Projeto-Jupiter/PyInstrumentation2/codes/pc/hybrid_feeding_gui/trash/WhatsApp_Video_2022-12-29_at_21_48_26_AdobeExpress (1).gif

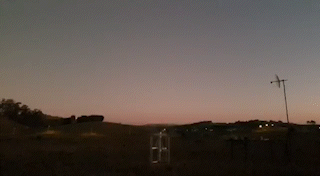
codes/pc/hybrid_feeding_gui/trash/WhatsApp_Video_2022-12-29_at_21_48_26_AdobeExpress (1).gif
