Projeto-Jupiter/PyInstrumentation2/circuits/Designer Report - circpot_valves.pdf

Infineon Designer powered by TINACloud | Design Report: circpot_valves

## circpot_valves

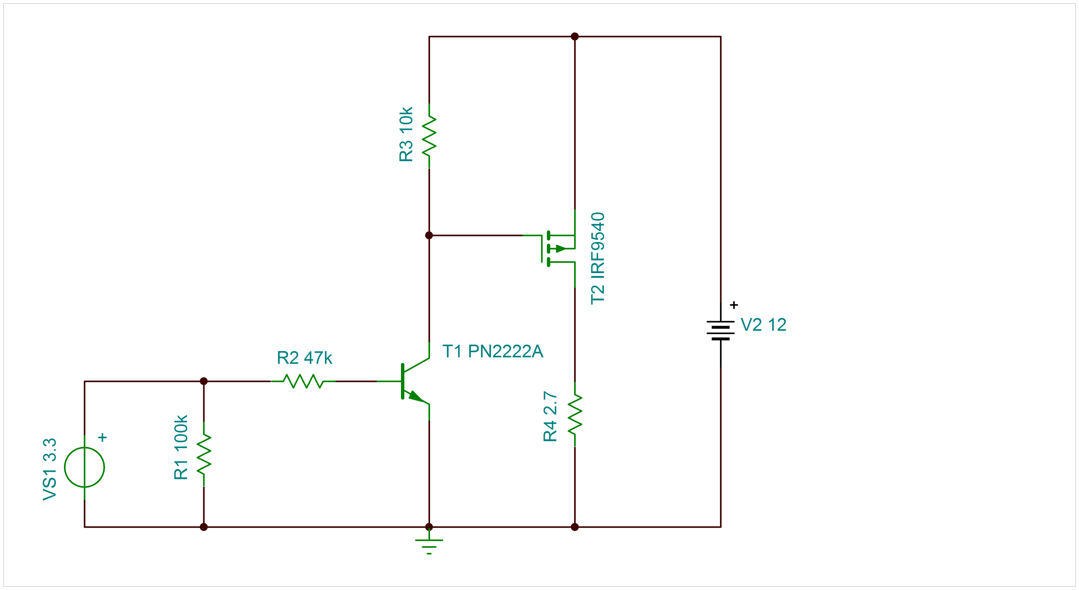
[picture p2: figure]

Bill of Materials

Type | Name | Value | Footprint
NPN Transistor Bipolar | T1 | PN2222A
PMOS do tipo acumulação | T2 | IRF9540
Resistência x 4 | R1, R2, R3, R4 | 100k, 10k, 2.7, 47k | RESC0603X26N x 4
Page 1 of 2 | 2023-01-12 06:44:16

Infineon Designer powered by TINACloud | Design Report: circpot_valves

## Disclaimer

Warranties and Disclaimers

- All Materials in this Report are provided "as is". Infineon makes no warranties or representations with regard to these Material of any kind, whether express or implied, including without limitation, warranties or representations of merchantability, fitness for a particular purpose, title and non-infringement of any third party intellectual property right. In particular, the user acknowledges and agrees that the application notes, reference designs simulations and/or other such design materials on this Report (hereinafter "Design Materials") are provided as an example only and that user will exercise its own independent analysis and judgment in its use of the Design Materials. Infineon assumes no liability for use of the Design Materials and/or user's product designs and/or any applications assistance provided by Infineon. Except for the rights of use and other rights expressly granted herein, no other rights are granted to the user nor shall anyobligation be implied requiring the grant of further rights. Use of the Materials on this Report may require a license from a third party, or a license from Infineon.
- Infineon reserves the right to make corrections, deletions, modifications, enhancements, improvements and other changes to the Materials, its products, programs and services at any time or to move or discontinue any Materials, products, programs, or services without notice.

Liability

a) Nothing in these Terms of Use shall limit or exclude Infineon's liability under mandatory liability laws, for injuries to life, body or health, for fraudulent concealment of defects, or in cases of Infineon's intentional misconduct or gross negligence.
b) Without prejudice to Section Liability a) above, in cases of Infineon's slight negligent breach of obligations that restrict essential rights or duties arising from the nature of these Terms of Use or of an obligation whose observance the user regularly may trust in, Infineon's liability shall be limited to the typical, foreseeable damage.
c) Without prejudice to Sections Liability a) and b) above, Infineon's liability under these Terms of Use shall be excluded in all other cases.

Reference: http://www.infineon.com/cms/en/about-infineon/usage-terms/

For questions please contact our support team: http://www.infineon.com/support

Page 2 of 2 | 2023-01-12 06:44:16
