Projeto-Jupiter/PyInstrumentation2/docs/Slides Instrumentação e Controle de Válvulas do Sistema de Alimentação de um Foguete Híbrido.pdf

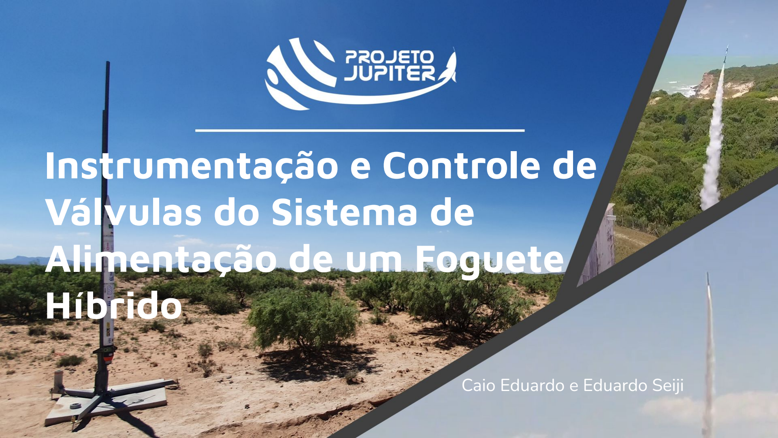
[picture p3: page 1]

## Instrumentação e Controle de Válvulas do Sistema de Alimentação de um Foguete Híbrido

Caio Eduardo e Eduardo Seiji

2

## Roteiro

- Contextualização ● Objetivos ● Visão geral ● Microcomputador ● Instrumentação ○ Termistor ○ Transdutor de Pressão ○ Microcontrolador ● Atuação ○ Válvulas ○ Desengate rápido ● Resultados

3

## Contextualização

Esquema geral do foguete

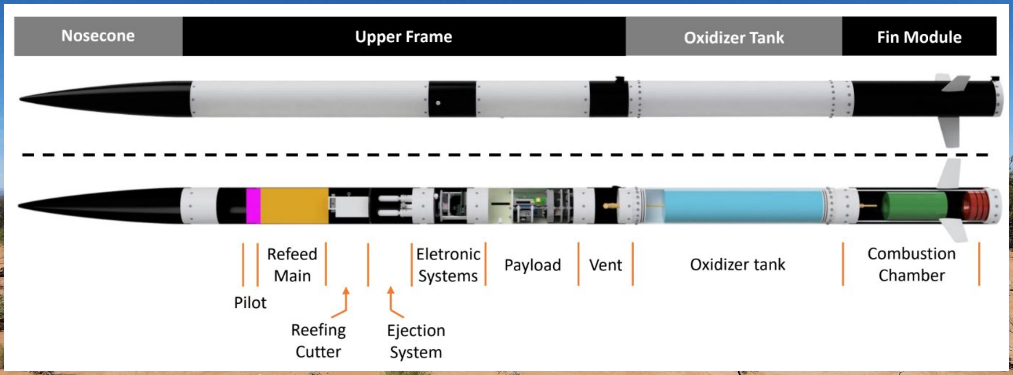
[picture p4: figure]

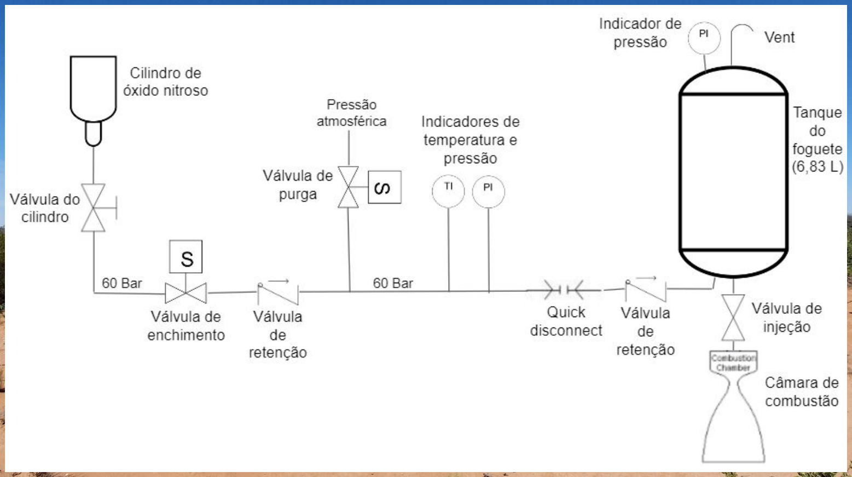
[picture p5: figure]

4

## Contextualização

P&ID (Pipe Instrumentation Design)

5

## Objetivos

- Instrumentação do sistema de alimentação
- Leitura de temperatura
- Leitura de pressão
- Atuação
- Atuação das válvulas de controle de abastecimento e purga
- Atuação do sistema de desengate rápido
- Telemetria
- Comunicação com a base de operações

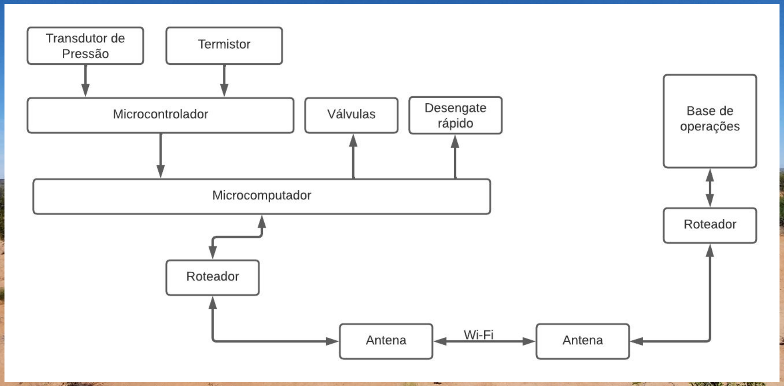
[picture p6: figure]

6

## Visão geral

Esquema simplificado do sistema (final)

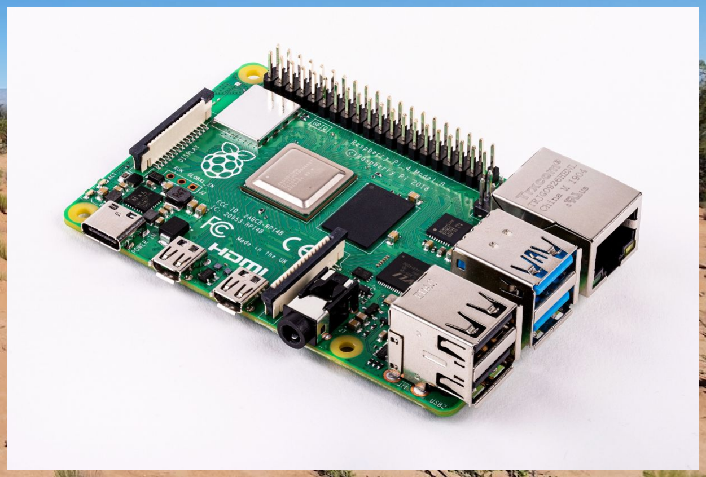
[picture p7: figure]

7

## Microcomputador

Raspberry Pi
- Alto poder de processamento e capacidade de realizar múltiplas tarefas simultaneamente;
- Conexões: Ethernet, GPIO, USB

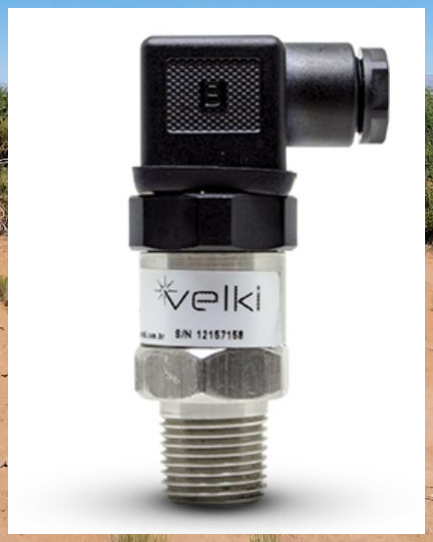
[picture p8: figure]
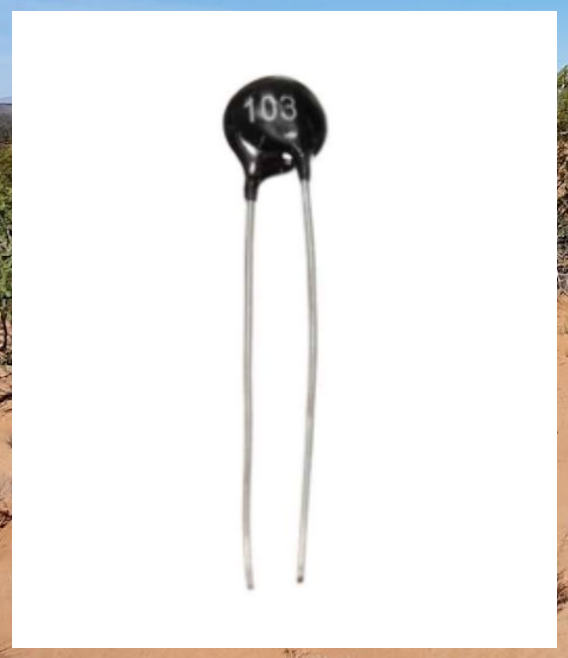
[picture p9: figure]
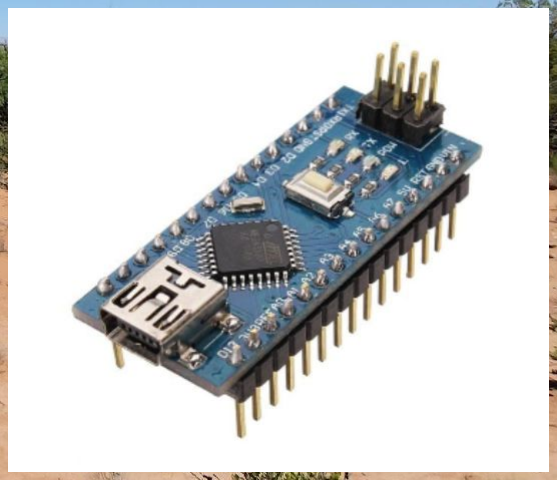
[picture p10: figure]

8

## Instrumentação

- Termistor
- Transdutor de Pressão
- Microcontrolador (com conversor analógico-digital)

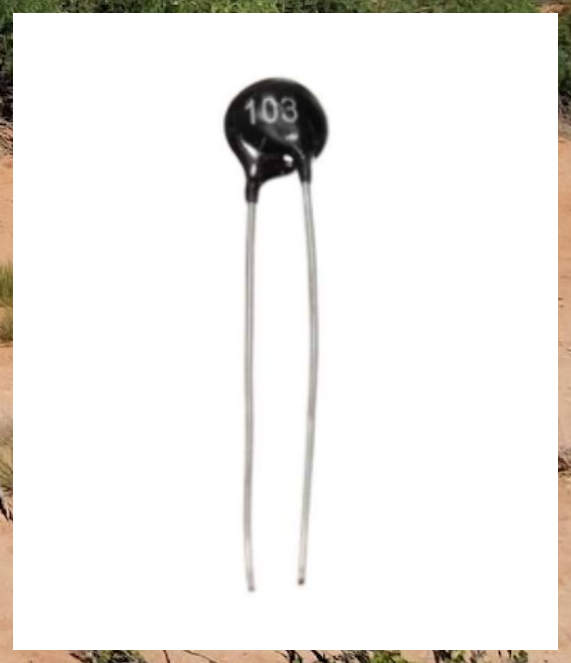
[picture p11: figure]

9

## Termistor

Cantherm NTC MF52 10K
- Faixa de medição: -55 a 125 ºC
- Tolerância: 1%
- Conexão: medição será feita externamente à tubulação (aço, 0,89 mm de espessura), com pasta térmica

## Termistor

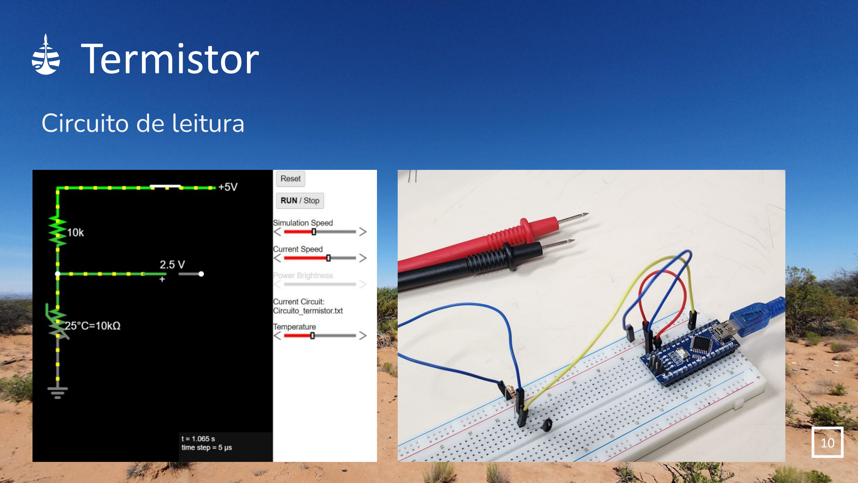
[picture p12: page 10]

10

Circuito de leitura

## Termistor

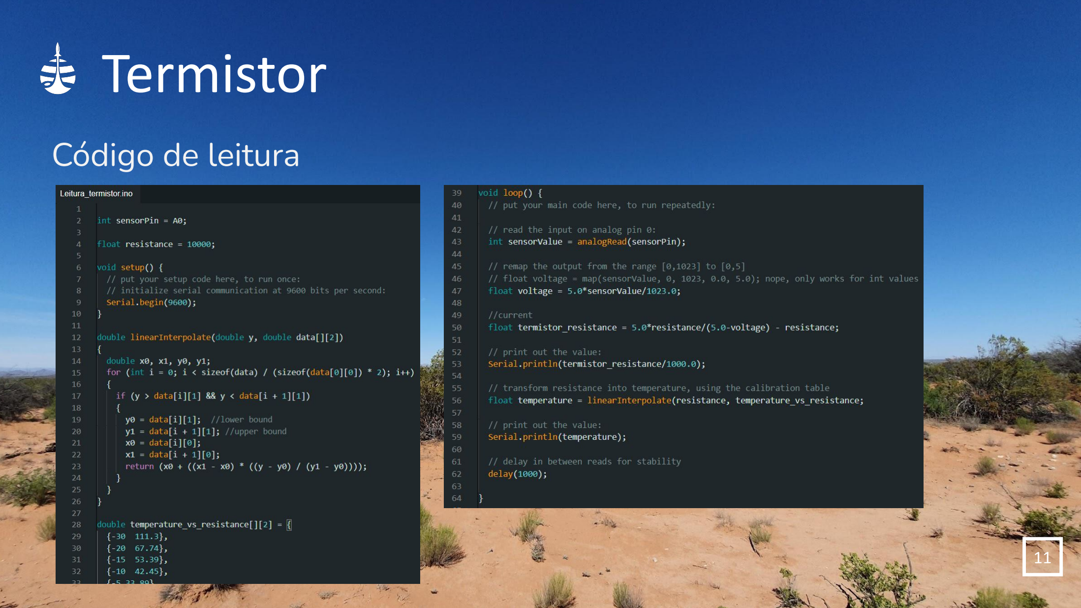
[picture p13: page 11]

11

Código de leitura

## Termistor

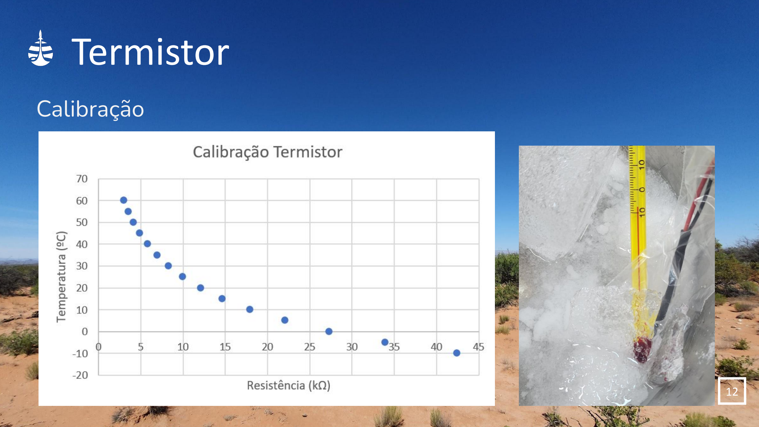
[picture p14: page 12]

12

Calibração

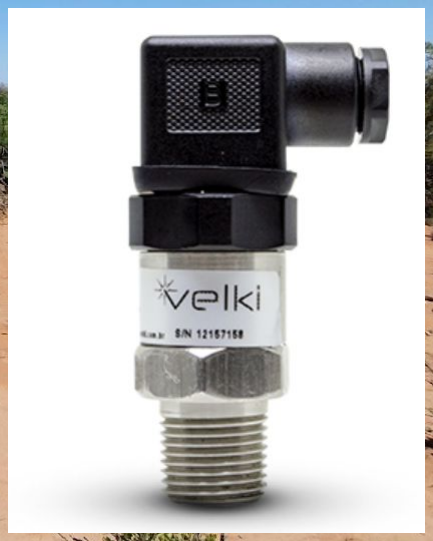
[picture p15: figure]

13

## Transdutor de Pressão

Velki VKP-011
- Faixa de medição: 0 a 200 bar
- Sensibilidade: 0,1 bar
- Material (diafragma e invólucro): aço inoxidável AISI-316L
- Corrente de saída: 4 a 20 mA
- Conexão: ¼” NPT

## Transdutor de Pressão

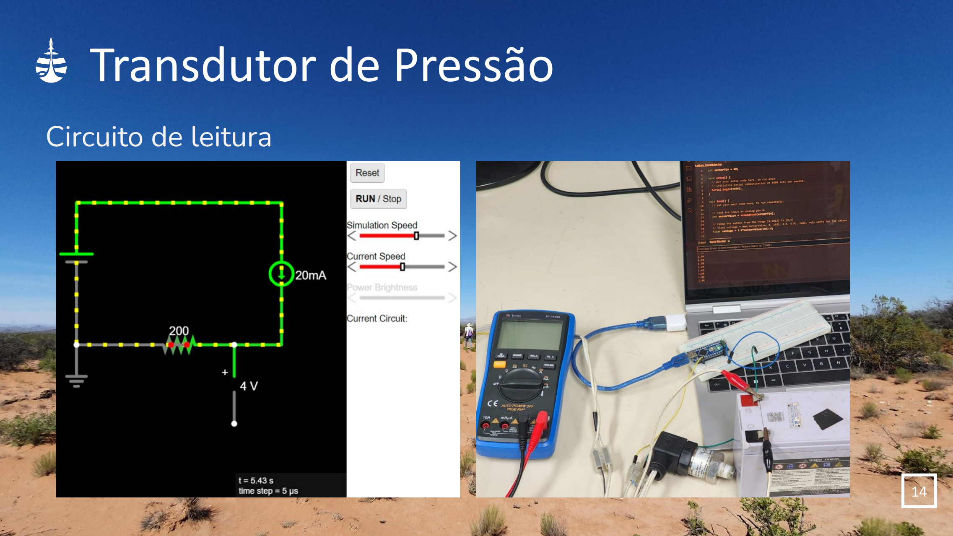
[picture p16: page 14]

14

Circuito de leitura

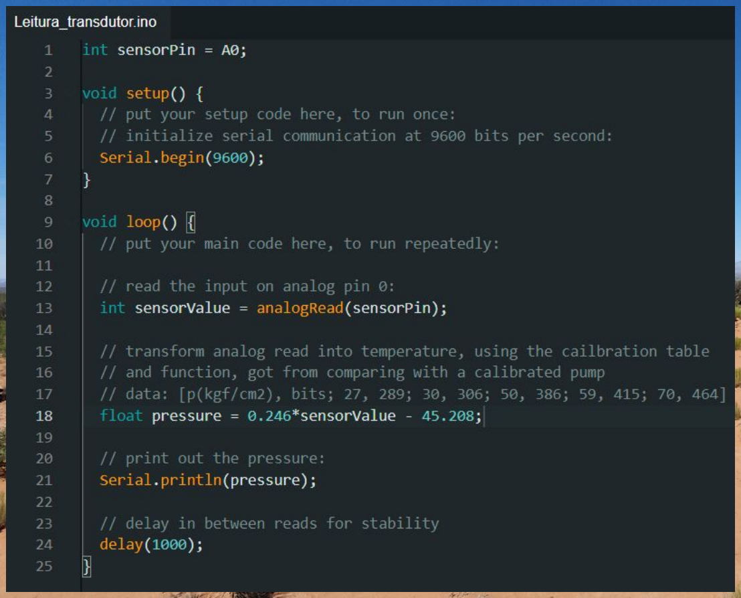
[picture p17: figure]

15

## Transdutor de Pressão

Código de leitura

## Transdutor de Pressão

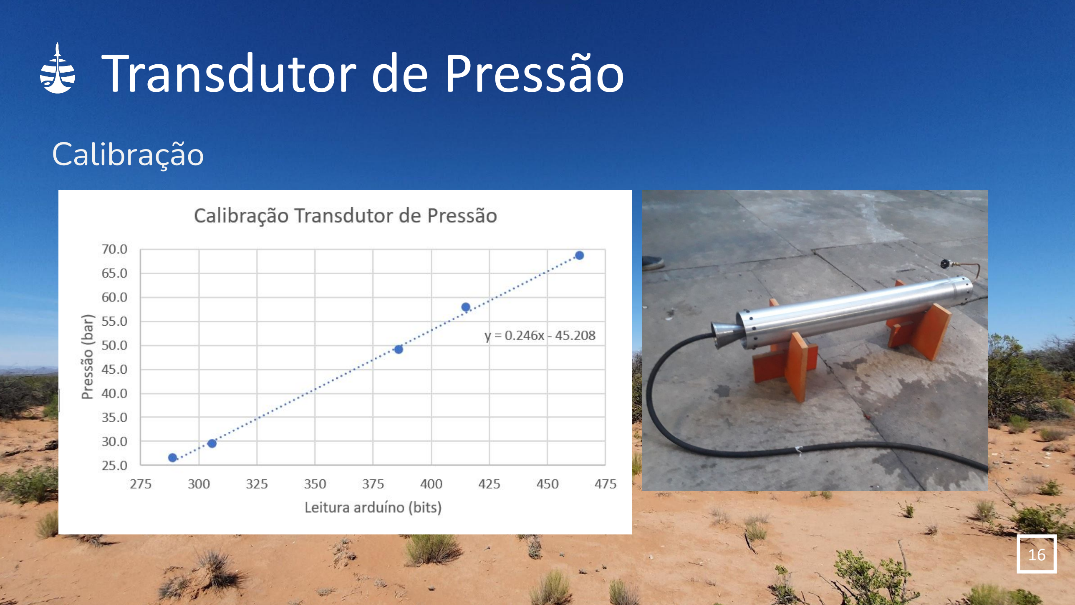
[picture p18: page 16]

16

Calibração

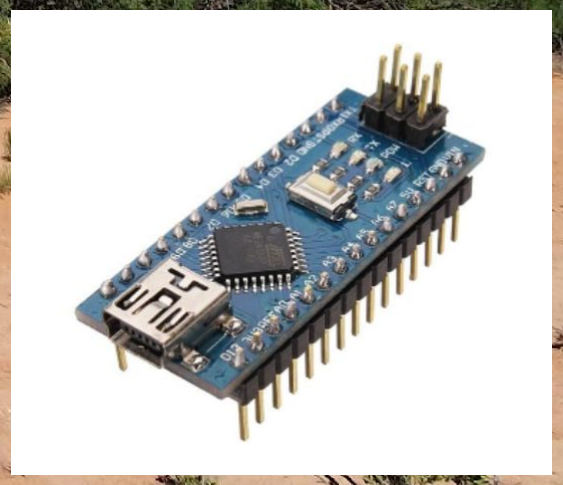
[picture p19: figure]

17

## Microcontrolador

Arduíno Nano
- Conversor analógico-digital;
- Comunicação serial com o RaspberryPi;
- Resolução 10 bits;
- Tensão de operação: 2 a 5,5 V.
- Tensão de entrada analógica: -0,3 a VDD + 0,3 V.

18

## Atuação

- Visão geral do subsistema;
- Válvulas;
- Circuito de potência;
- Análise de resultados para o circuito de potência;
- Adaptação do sistema para acionamento do desengate rápido.

19

## Visão geral do subsistema

- Circuito de potência, pois as GPIOs do Raspberry Pi não fornecem energia suficiente para acionar as válvulas;
- Utilização de uma associação entre transistores do tipo BJT e MOSFET para chaveamento do circuito;
- Bateria de especificações 12 V - 7 Ah para a alimentação.

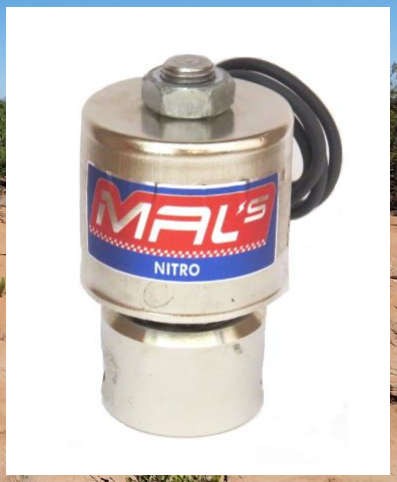
[picture p20: figure]

20

## Válvulas

Válvula Mal’s Nitro Solenóide de Nitro
- Tipo: agulha
- Atuador: solenóide
- Tensão nominal: 12 V
- Corrente máxima: 6 A
- Pressão de trabalho: 82,74 bar
- Material: latão niquelado
- Conexões: ⅛” NPT

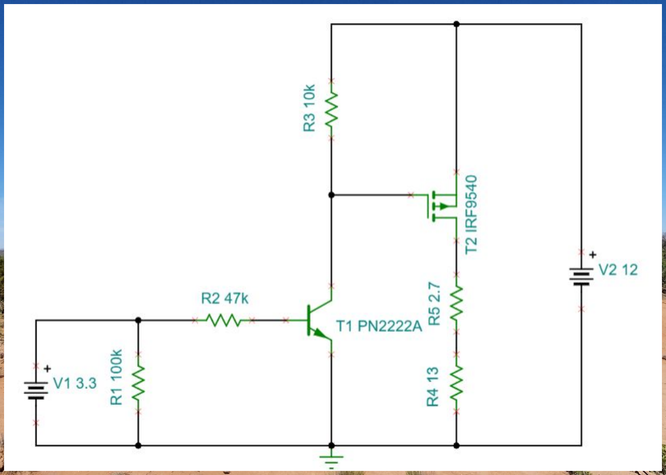
[picture p21: figure]

21

## Circuito de Potência

## Análise do Circuito de Potência

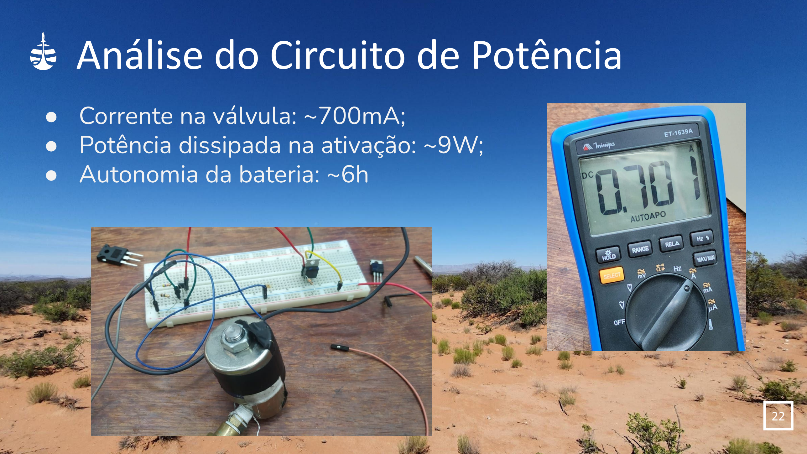
[picture p22: page 22]

22

- Corrente na válvula: ~700mA;
- Potência dissipada na ativação: ~9W;
- Autonomia da bateria: ~6h

23

## Desengate rápido

- Rompimento de um fio polimérico por aquecimento de um fio de Ni-Cr por efeito Joule;
- Temperatura de rompimento do fio polimérico: 144ºC;
- Resistência do fio de Ni-Cr: 0,5Ω.

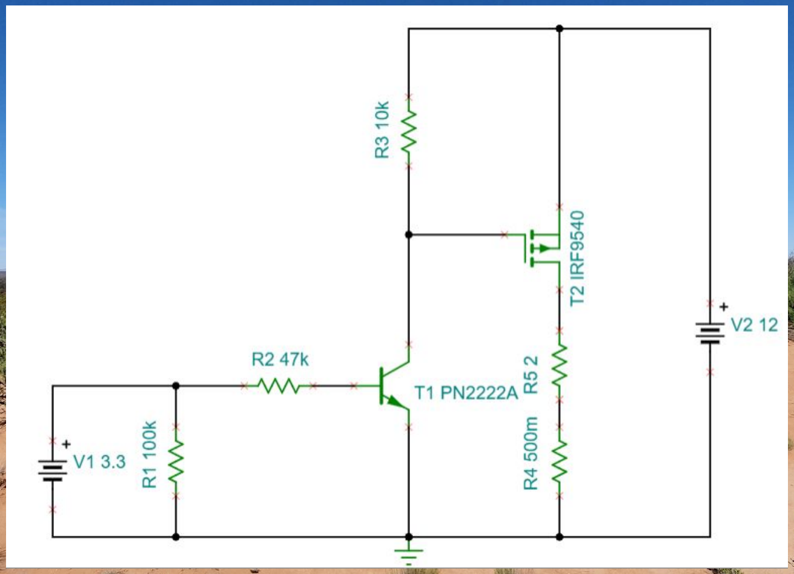
[picture p23: figure]

24

## Adaptação do circuito para o desengate rápido

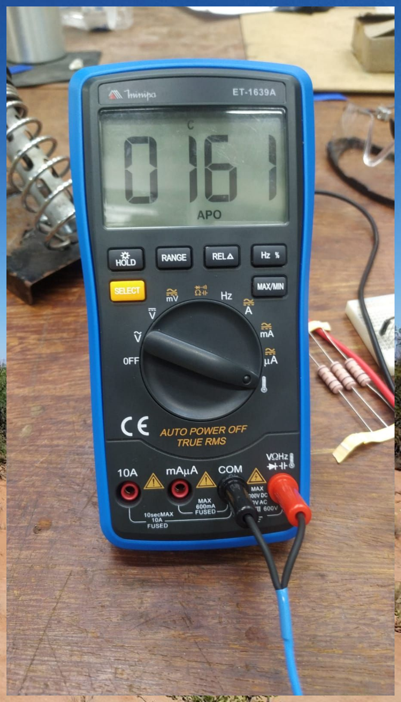
[picture p24: figure]

25

## Análise do Circuito de Potência

- Corrente no fio de Ni-Cr: ~4,5A;
- Potência dissipada no fio: ~10W;
- Temperatura na qual o fio chega: ~160ºC

26

## Resultados

Tarefas concluídas
- Circuitos e códigos de leitura dos sensores de temperatura e pressão;
- Calibração dos sensores;
- Circuito de potência para ativação de válvulas;
- Códigos para a utilização das GPIOs do RaspberryPi para ativação das válvulas.

Próximas etapas
- Fazer a comunicação serial entre o Arduíno e o RaspberryPi;
- Fazer a comunicação por telemetria com o usuário.
