Projeto-Jupiter/PyInstrumentation2/circuits/Table of DC Results - circpot_valves.txt

V_R1	-3.3V
V_R2	2.53V
V_R3	-11.95V
V_R4	-11.4V
V_V2	12V
V_VS1	3.3V
I_R1	-33uA
I_R2	53.86uA
I_R3	-1.19mA
I_R4	-4.22A
I_VS1	-86.86uA
