Projeto-Jupiter/PyInstrumentation2/(commit log)

2023-01-12 circuit added
2023-01-13 Valves drive and data receive with GUI
2023-01-14 Final version started
    [2023_01_14__00_27_17.csv]
2023-01-16 Thermistor, Transducer and docs
    The Thermistor and Transducer reading codes were added
    Final report and slide also added
2023-01-19 Loadcell calibration
    Loadcell was calibrated with a 2.952kg object. Its output is printed in N.
2023-01-20 Transducer code
    Some changes in the transducer code, to calibrate it
2023-07-25 Thermistor Calibration
    Thermistor calibration pre static fire test 24/7/2023
